eb8ga/FYEC-Demo/subsystems/mechanical/README.md

# Mechanical

**Part:** 3D-printed case: body and cover, 60 × 90 × 46 mm

Role card: [05-mechanical](../../docs/role-cards/05-mechanical.md)

## Adafruit Learn guides

- [Adafruit 3D printing guides](https://learn.adafruit.com/category/3d-printing)

## Design files

- [Enclosure print files: body and cover, 3MF (this repo)](../../fab/enclosure/)
- [Enclosure body 3D model: STEP (this repo)](../../cad/enclosure/enclosure-v_01.step)
- [Enclosure cover 3D model: STEP (this repo)](../../cad/enclosure/cover.step)
- [3D models of the boards, ready to assemble (this repo)](../../cad/README.md)
- [QT Py RP2040 fab print (board outline and dimensions)](https://learn.adafruit.com/adafruit-qt-py-2040/downloads)
- [Charger fab print](https://learn.adafruit.com/adafruit-microlipo-and-minilipo-battery-chargers/downloads)
- [OLED module user manual, for dimensions (MC091GX)](https://www.lcdwiki.com/res/MC091GX/0.91inch_IIC_OLED_Module_MC091GX_User_Manual_EN.pdf)
- [OLED breakout 3D model (STEP)](../../cad/oled-breakout/91inOLED-BOB-CAD.step)
- [Power board 3D model (STEP)](../../cad/power-board/chargingPowerConnection-CAD.step)
- [BME688 fab print (for the vent)](https://learn.adafruit.com/adafruit-bme680-humidity-temperature-barometic-pressure-voc-gas/downloads)

## Note

Use the 3D models in ../../cad/ to check the vent, window, light pipe holes and USB-C opening against real part positions. Threaded inserts: CNC Kitchen M2.5 x 4 mm for the circuit boards, with nylon M2.5 screws, and M3 x 5 x 4 (Voron) for the cover, with stainless steel M3 socket head cap screws (SHCS). They go in with the heat-set insert press: read ../../safety/heat-set-insert-press/README.md first.
