eb8ga/FYEC-Demo/docs/role-cards/README.md

# Role cards

Each role gets one printed card. Each card holds facts the rest of the team needs.

| Card | Role |
| --- | --- |
| [01-sensor](01-sensor.md) | Sensor |
| [02-microcontroller-and-code](02-microcontroller-and-code.md) | Microcontroller + Code |
| [03-power](03-power.md) | Power |
| [04-human-interaction](04-human-interaction.md) | Human Interaction |
| [05-mechanical](05-mechanical.md) | Mechanical |

Six people: two share the Microcontroller + Code card.

## Build

No set order. The team works out how the pieces go together, like a puzzle.

| Who | Build task |
| --- | --- |
| Sensor + Microcontroller + Code | Sensor cable into the microcontroller's STEMMA QT port. |
| Power | Battery, charger and switch into the power board. |
| Microcontroller + Code | The QT Py's red and black wires into the 5V and GND blocks. Program and test once everything is connected. |
| Human Interaction | OLED from the sensor's free port. Light pipes in. |
| Mechanical | Seat every part in the case. Lid stays off until the test passes. |

Two rules:

- Switch OFF until everything is connected.
- The lid goes on last, after the test passes.
