eb8ga/FYEC-Demo/subsystems/code/README.md

# Code

**Part:** code.py on the CIRCUITPY drive

Role card: [02-microcontroller-and-code](../../docs/role-cards/02-microcontroller-and-code.md)

## Adafruit Learn guides

- [Welcome to CircuitPython](https://learn.adafruit.com/welcome-to-circuitpython)
- [QT Py RP2040: CircuitPython setup](https://learn.adafruit.com/adafruit-qt-py-2040/circuitpython)
- [QT Py RP2040: connecting to the serial console](https://learn.adafruit.com/adafruit-qt-py-2040/connecting-to-the-serial-console)
- [Keep libraries up to date with circup](https://learn.adafruit.com/keep-your-circuitpython-libraries-on-devices-up-to-date-with-circup)

## Library docs

- [CircuitPython BME680 library docs](https://docs.circuitpython.org/projects/bme680/en/latest/)
- [CircuitPython SSD1306 library docs](https://docs.circuitpython.org/projects/ssd1306/en/latest/)
- [CircuitPython NeoPixel library docs](https://docs.circuitpython.org/projects/neopixel/en/latest/)

## Note

The program is in ../../device/CIRCUITPY/code.py. Set points are in section 2.
