eb8ga/FYEC-Demo/docs/team-worksheet.md

# Team worksheet

One per team. Print double-sided: team page on the front, exit tickets on the back.

## Front: team

**Team / role:**

**Our application** (the room picks one when Human Interaction opens Share):

**Our 2 statements:** what other teams most need to know from us

1.

2.

**Our question, to team:**

**Their answer:**

**What broke, and how we fixed it** (during the build: what you saw, what caused it, what you changed):

## Back: reflection (one per person)

Your answer to the reflection question the group picked. The questions are on the slides.
