eb8ga/FYEC-Demo/cad/adafruit/4410-micro-lipo-usbc/4410 Micro Lipo USBC.jpg

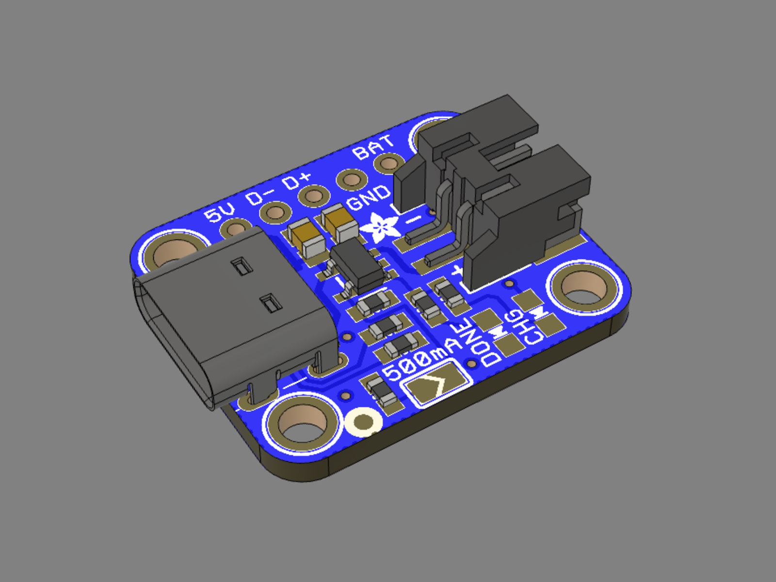
cad/adafruit/4410-micro-lipo-usbc/4410 Micro Lipo USBC.jpg
