eb8ga/FYEC-Demo/cad/adafruit/4900-qtpy-rp2040/4900 QTPY-RP2040.gif

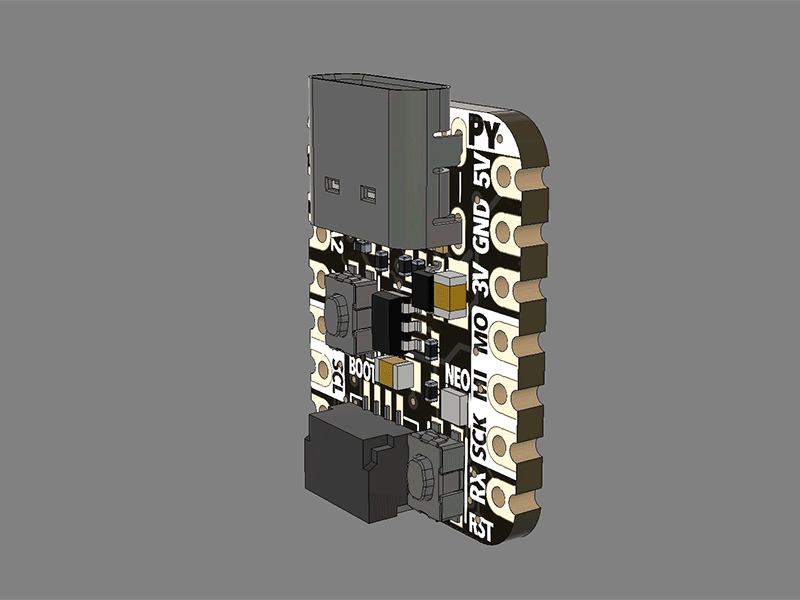
cad/adafruit/4900-qtpy-rp2040/4900 QTPY-RP2040.gif
