eb8ga/FYEC-Demo/cad/adafruit/5046-bme688/5046 BME688 Sensor.jpg

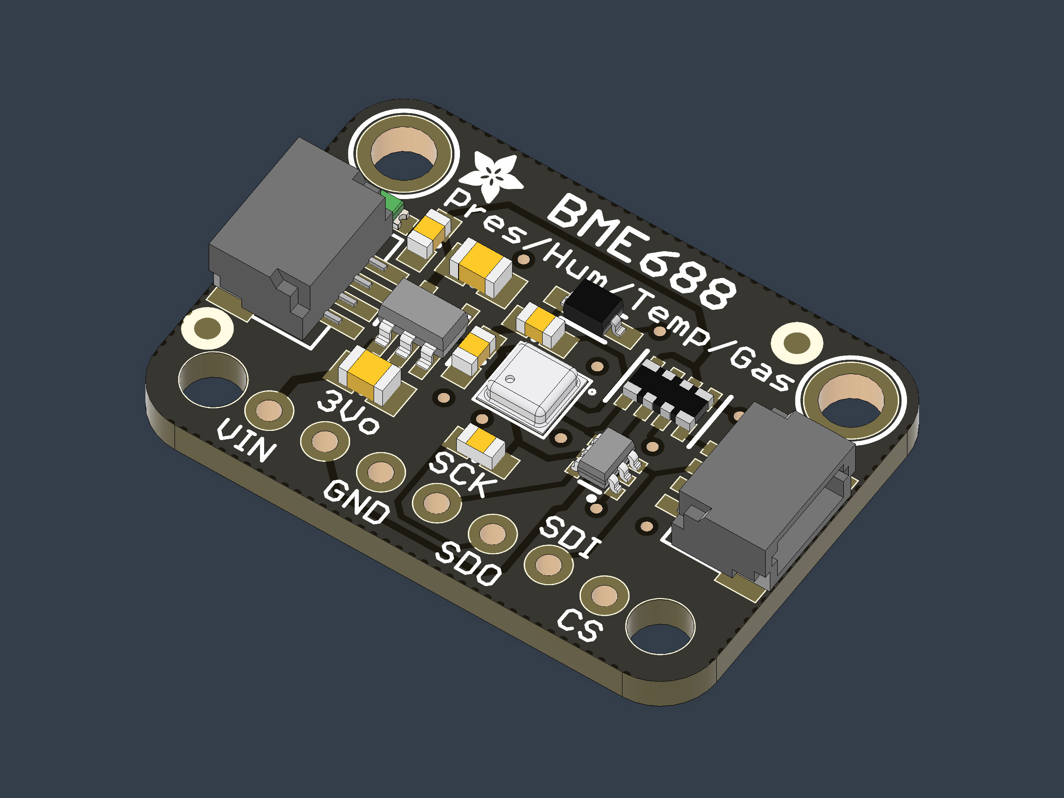
cad/adafruit/5046-bme688/5046 BME688 Sensor.jpg
