eb8ga/FYEC-Demo/docs/repo-qr.png

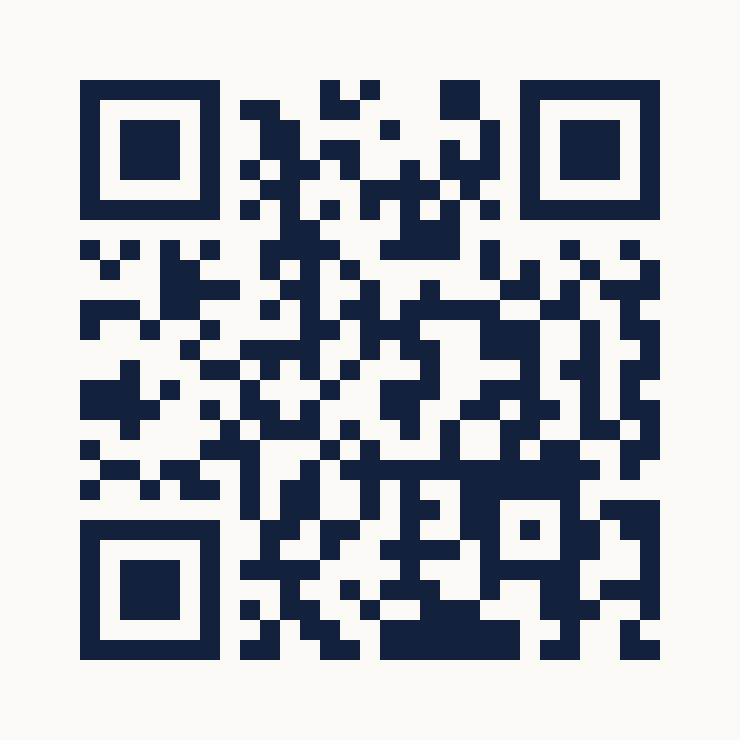
docs/repo-qr.png
