eb8ga/FYEC-Demo/subsystems/power/power-board/power-board-3d.png

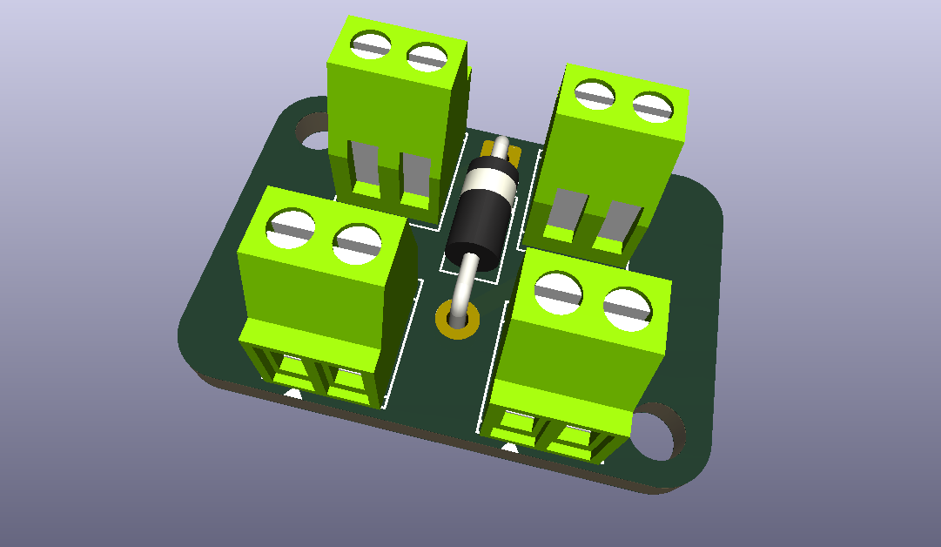
subsystems/power/power-board/power-board-3d.png
