eb8ga/FYEC-Demo/subsystems/power/power-board/power-board-schematic.png

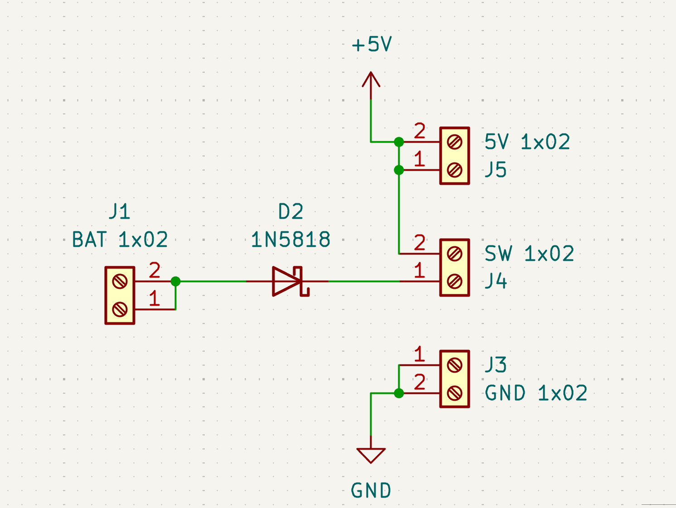
subsystems/power/power-board/power-board-schematic.png
