eb8ga/FYEC-Demo/cad/adafruit/4410-micro-lipo-usbc/4410 Micro Lipo USBC.step

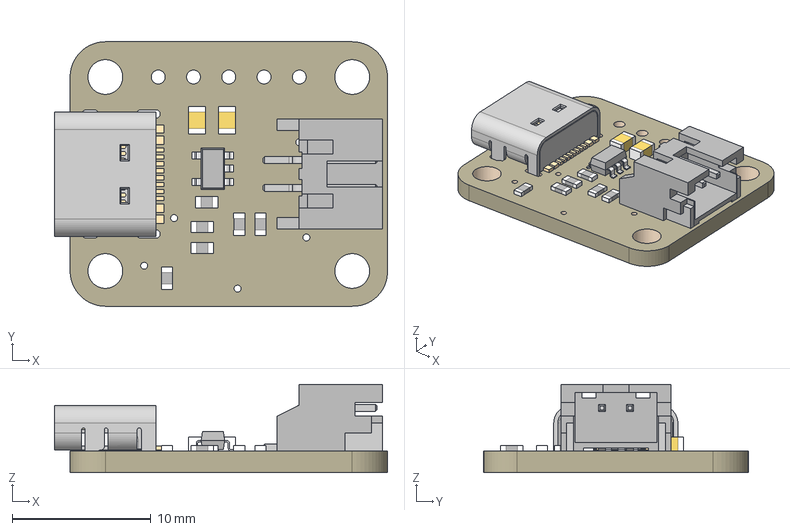
[picture p13: CAD file, 2026-11-11]
cad/adafruit/4410-micro-lipo-usbc/4410 Micro Lipo USBC.step
24.0 x 19.1 x 6.37 mm
Board
MCP73831T-2ACI/OT
5.1K x 6
JSTPH
10µF x 2
USB_C_CUSB31-CFM2AX-01-X
