eb8ga/FYEC-Demo/cad/adafruit/4900-qtpy-rp2040/4900 QTPY-RP2040.step

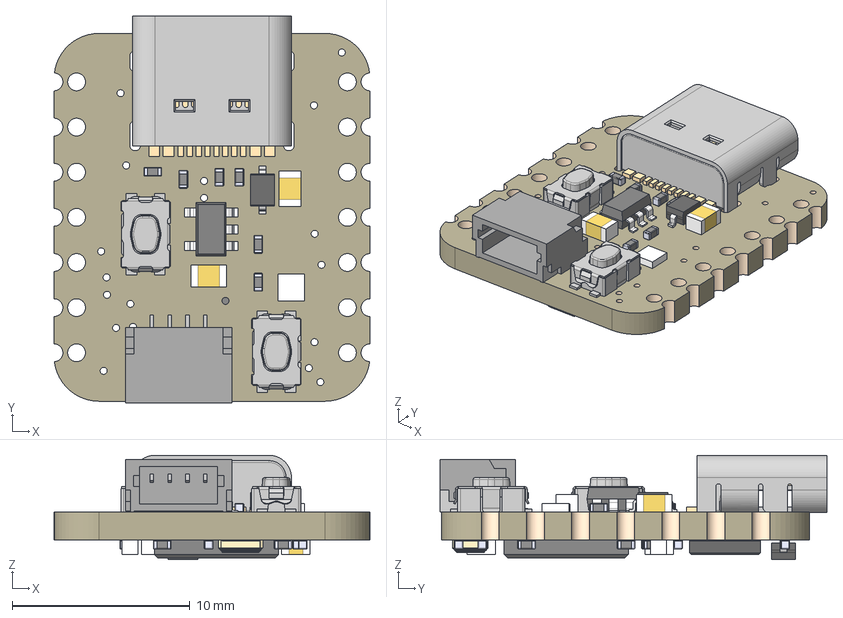
[picture p14: CAD file, 2026-11-11]
cad/adafruit/4900-qtpy-rp2040/4900 QTPY-RP2040.step
17.8 x 21.8 x 5.87 mm
Board
10uF x 2
STEMMA_I2C_QTSKINNY
AP2112K-3.3
WS2812B_SK6805_1515
NSR0320 x 2
8MB QSPI Flash
1K x 17
1uF x 3
USB Type C
RP2040_QFN56
KMR2 x 2
12MHZ
