eb8ga/FYEC-Demo/cad/adafruit/5046-bme688/5046 BME688 Sensor.step

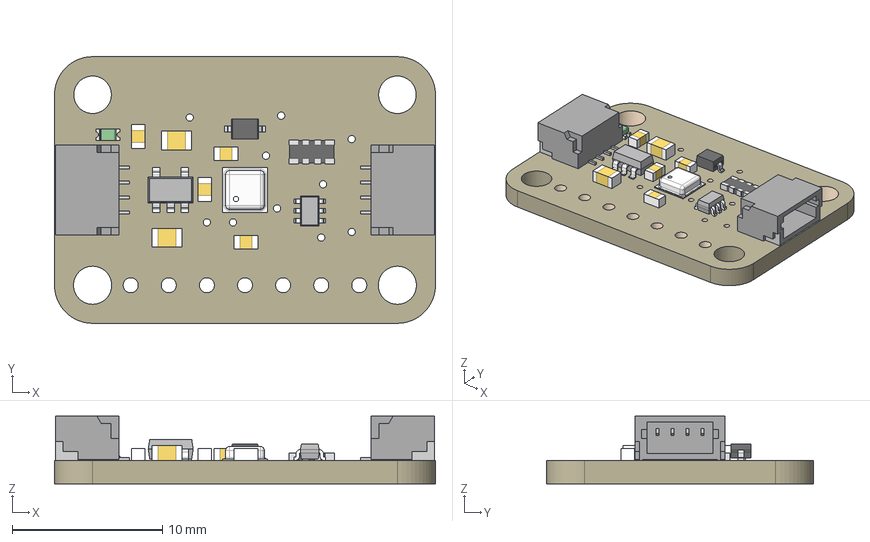
[picture p15: CAD file, 2026-11-11]
cad/adafruit/5046-bme688/5046 BME688 Sensor.step
25.4 x 17.8 x 4.53 mm
Board
10uF x 2
AP2112K-3.3
10K x 4
10K_1
BSS138
STEMMA_I2C_QT x 2
GREEN
1N4148
BME680
