eb8ga/FYEC-Demo/cad/enclosure/lightMCU.step

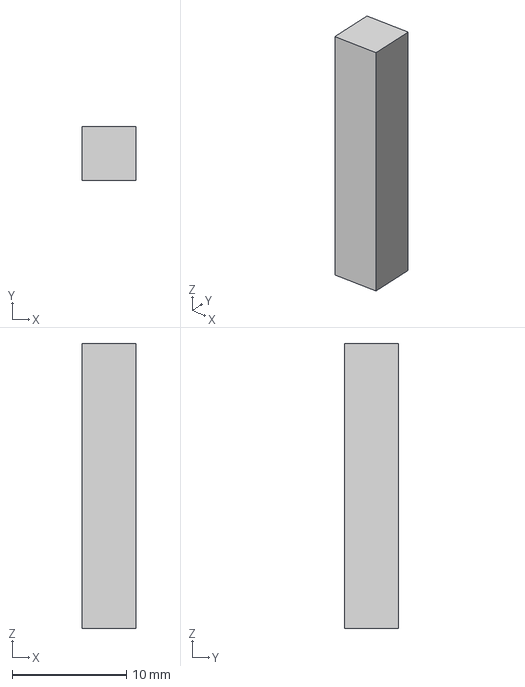
[picture p16: CAD file, 2026-11-11]
cad/enclosure/lightMCU.step
4.75 x 4.75 x 25.0 mm
