eb8ga/FYEC-Demo/cad/oled-breakout/91inOLED-BOB-CAD.step

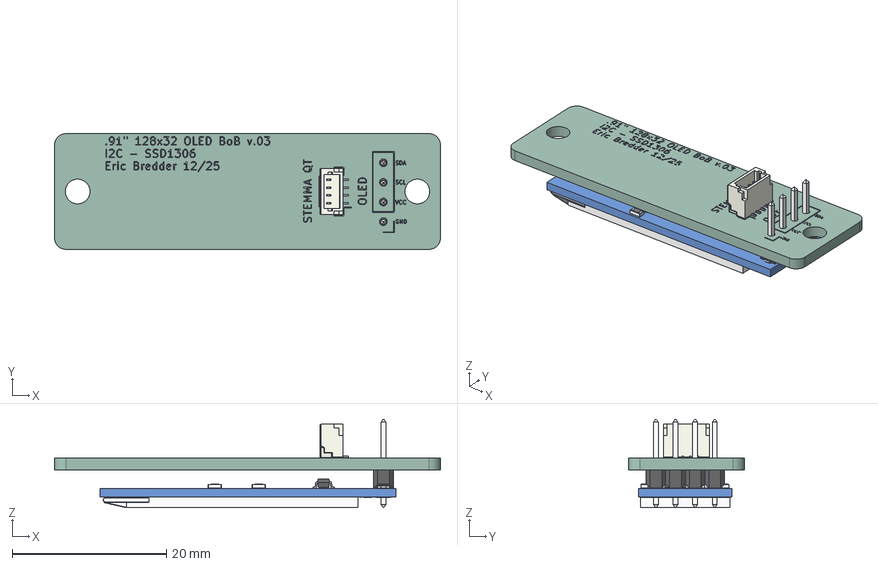
[picture p17: CAD file, 2026-11-11]
cad/oled-breakout/91inOLED-BOB-CAD.step
50.0 x 15.0 x 11.5 mm
OLED_0.91_128x32
Pin Header 4 x 1 TH 2.54mm Pitch
RESC-0603 x 13
2SD0601A
JST_SH_BM04B-SRSS-TB_1x04-1MP_P1.00mm_Vertical
BM04B-SRSS-TB
91inOLED-BOB_silkscreen x 2
91inOLED-BOB_PCB
