eb8ga/FYEC-Demo/cad/power-board/chargingPowerConnection-CAD.step

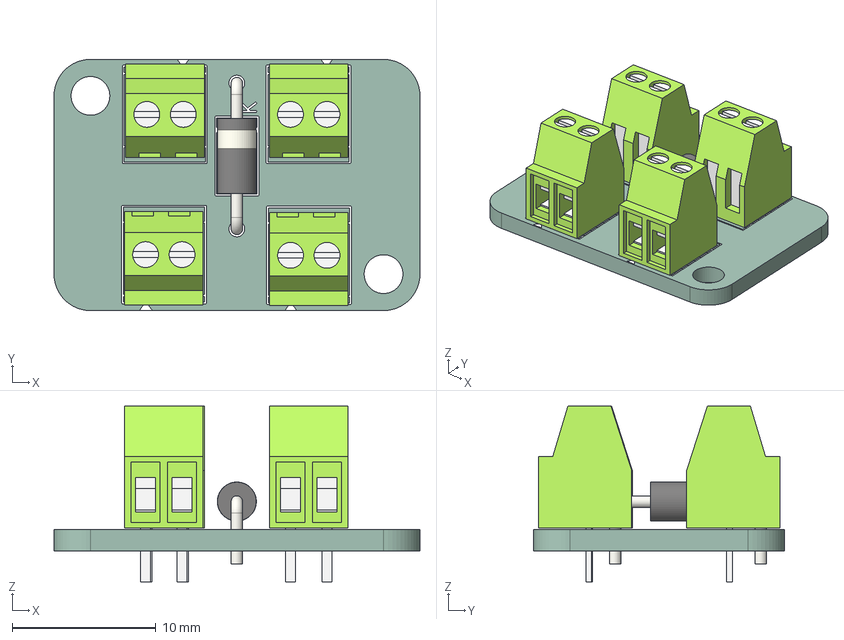
[picture p18: CAD file, 2026-11-11]
cad/power-board/chargingPowerConnection-CAD.step
25.5 x 17.5 x 12.3 mm
Housing x 4
PlasticBody x 4
D_DO-41_SOD81_P10.16mm_Horizontal
chargingPowerConnection_silkscreen
chargingPowerConnection_PCB
