eb8ga/FYEC-Demo/fab/enclosure/enclosure-v_01.3mf

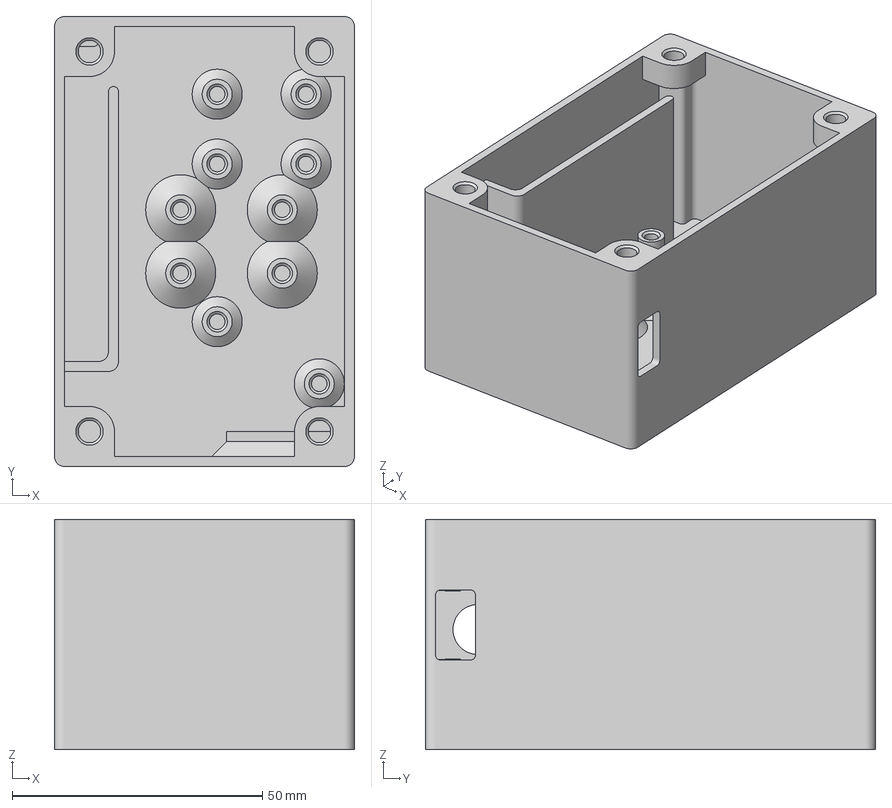
[picture p19: CAD file, 2026-11-11]
fab/enclosure/enclosure-v_01.3mf
60.0 x 90.0 x 46.0 mm
