eb8ga/FYEC-Demo/cad/enclosure/cover.step

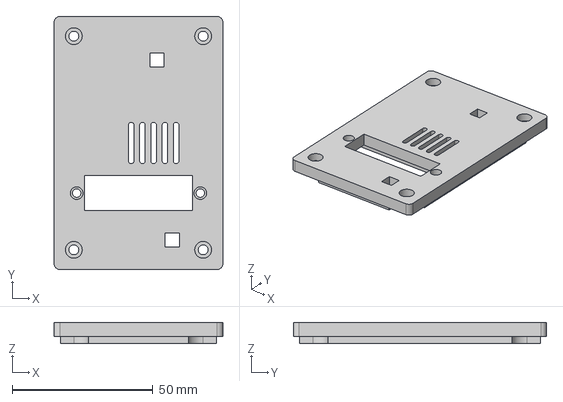
[picture p20: CAD file, 2026-11-11]
cad/enclosure/cover.step
60.0 x 90.0 x 7.50 mm
