eb8ga/FYEC-Demo/cad/enclosure/lightCharge.step

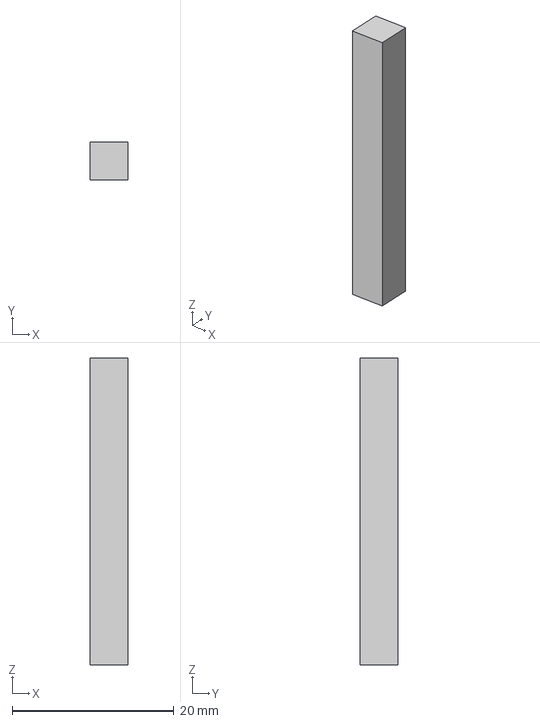
[picture p21: CAD file, 2026-11-11]
cad/enclosure/lightCharge.step
4.75 x 4.75 x 38.0 mm
