eb8ga/FYEC-Demo/(list of files, cad)

Other CAD files:
fab/enclosure/cover.3mf
cad/enclosure/enclosure-v_01.step
fab/enclosure/lightMCU.3mf
fab/enclosure/lightCharge.3mf
cad/adafruit/4410-micro-lipo-usbc/4410 Micro Lipo USBC.f3d
cad/adafruit/4410-micro-lipo-usbc/4410 Micro Lipo USBC.stl
cad/adafruit/4900-qtpy-rp2040/4900 QTPY-RP2040.f3d
cad/adafruit/4900-qtpy-rp2040/4900 QTPY-RP2040.stl
cad/adafruit/5046-bme688/5046 BME688 Sensor.3mf
cad/adafruit/5046-bme688/5046 BME688 Sensor.f3d
